vladtarakin178-maker/aiai-car/chassis/body_preview_back.png

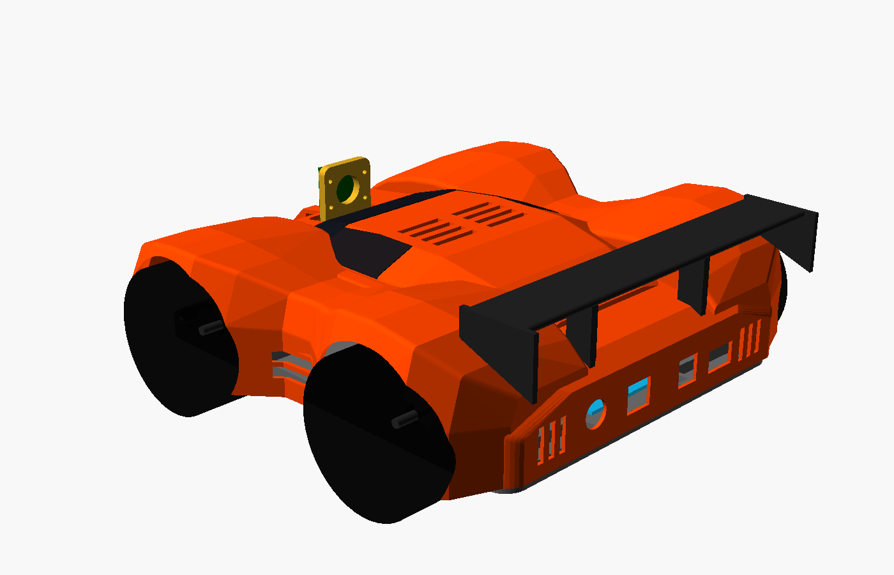
chassis/body_preview_back.png
