vladtarakin178-maker/aiai-car/chassis/body_preview_fit.png

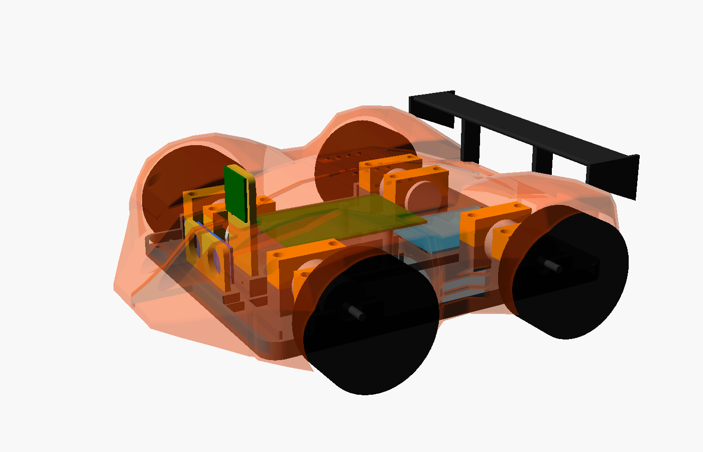
chassis/body_preview_fit.png
