vladtarakin178-maker/aiai-car/chassis/body_side.png

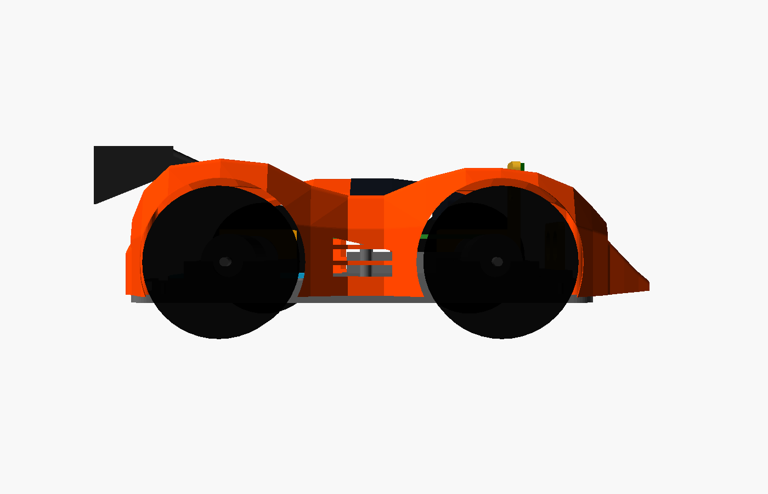
chassis/body_side.png
