vladtarakin178-maker/aiai-car/chassis/stl/body_fr.stl

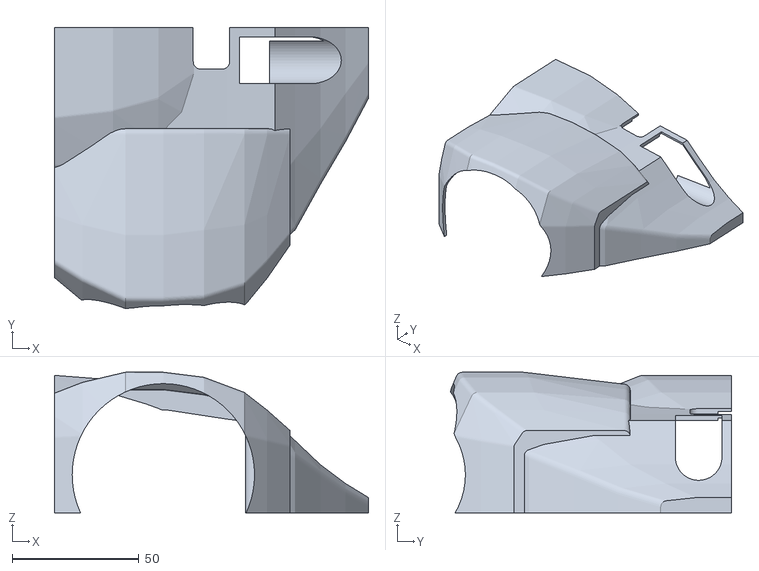
[picture p6: CAD file, 2026-10-30]
chassis/stl/body_fr.stl
124.0 x 111.0 x 55.5
