vladtarakin178-maker/aiai-car/chassis/stl/wing.stl

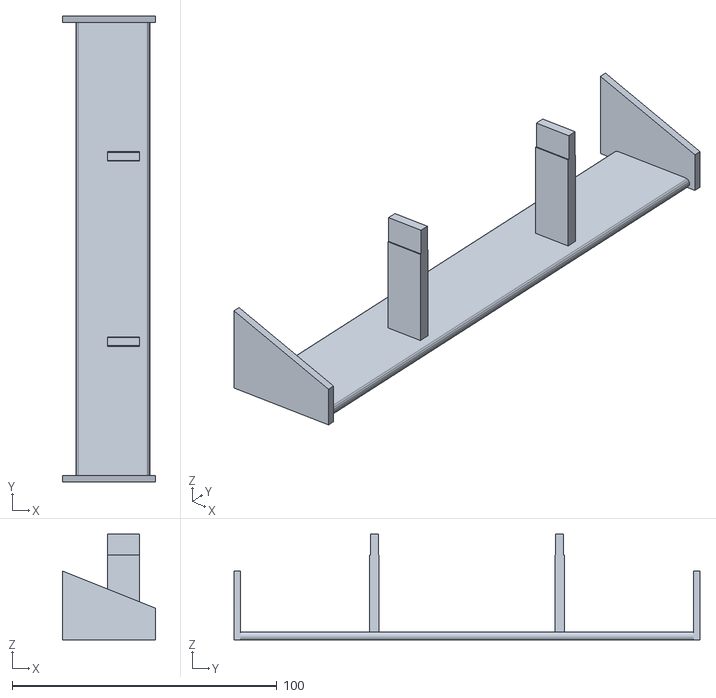
[picture p7: CAD file, 2026-10-30]
chassis/stl/wing.stl
35.0 x 176.0 x 40.0
