vladtarakin178-maker/aiai-car/chassis/stl/body_rl.stl

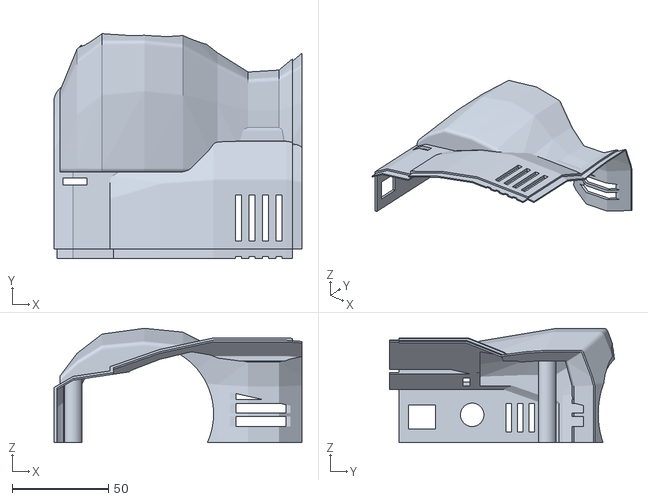
[picture p8: CAD file, 2026-10-30]
chassis/stl/body_rl.stl
129.0 x 117.0 x 59.5
