vladtarakin178-maker/aiai-car/chassis/stl/body_fl.stl

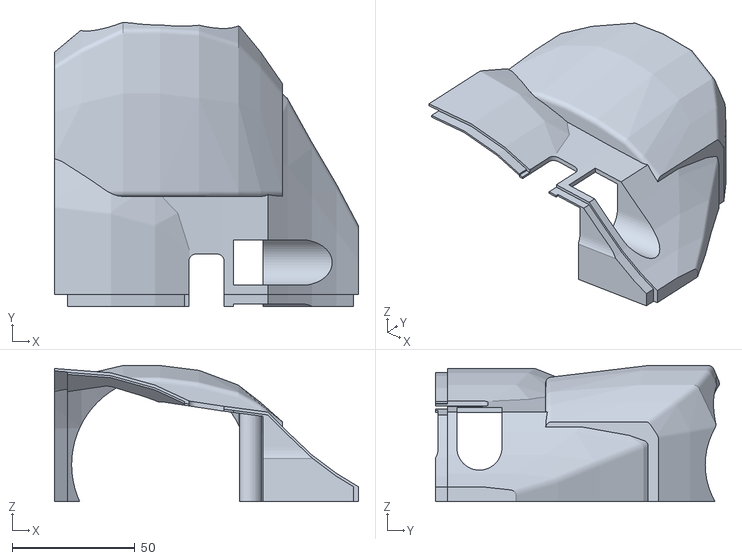
[picture p9: CAD file, 2026-10-30]
chassis/stl/body_fl.stl
124.0 x 116.0 x 55.5
