vladtarakin178-maker/aiai-car/chassis/stl/body_rr.stl

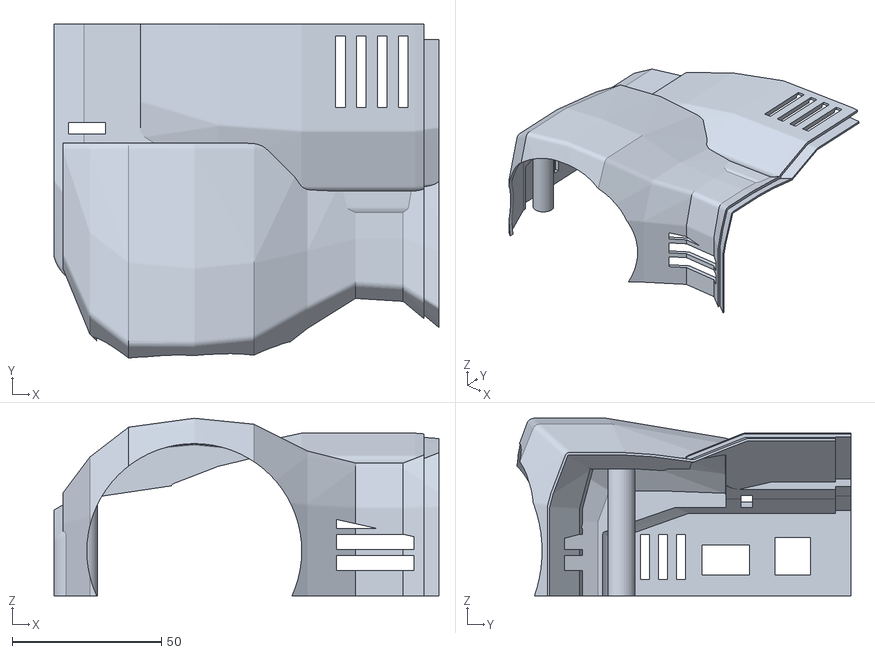
[picture p10: CAD file, 2026-10-30]
chassis/stl/body_rr.stl
129.0 x 112.0 x 59.5
