vladtarakin178-maker/aiai-car/chassis/stl/plate.stl

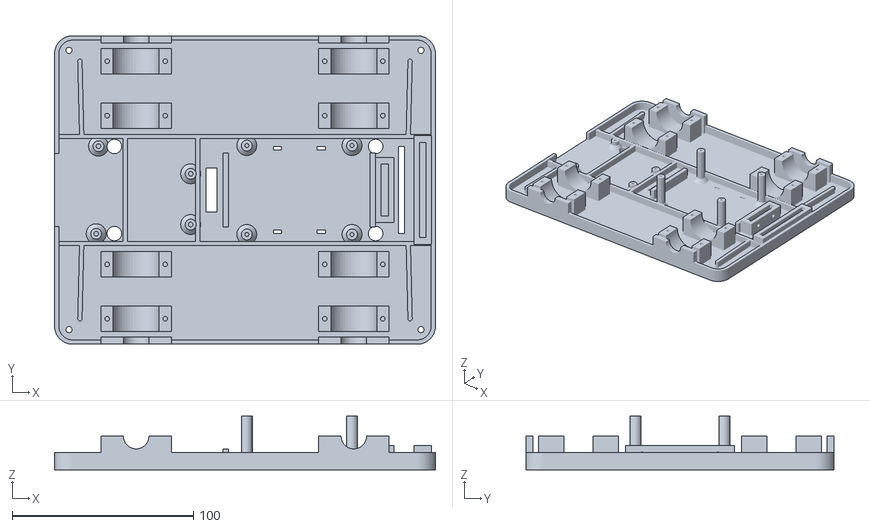
[picture p11: CAD file, 2026-10-30]
chassis/stl/plate.stl
210.0 x 170.0 x 29.5
