vladtarakin178-maker/aiai-car/chassis/stl/mast.stl

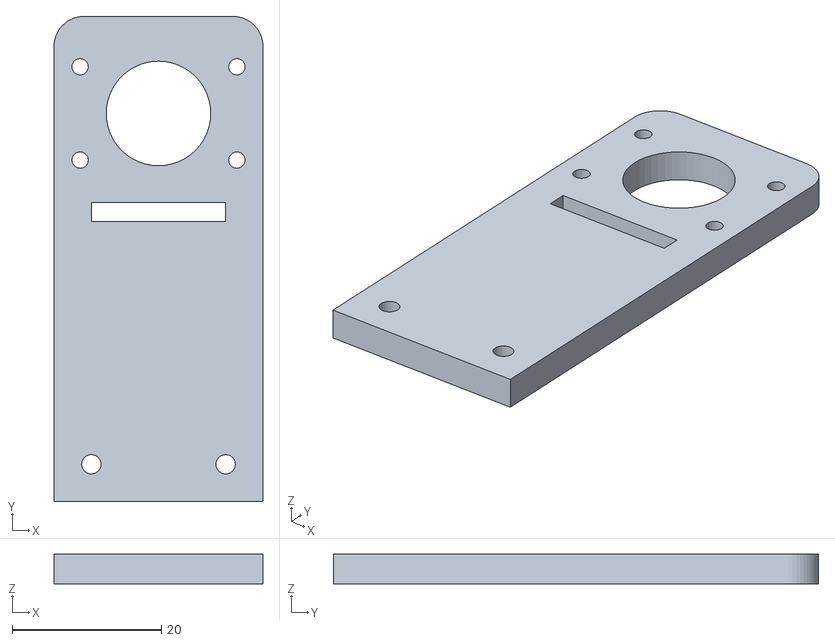
[picture p12: CAD file, 2026-10-30]
chassis/stl/mast.stl
28.0 x 65.0 x 4.00
