vladtarakin178-maker/aiai-car/chassis/stl/clamp.stl

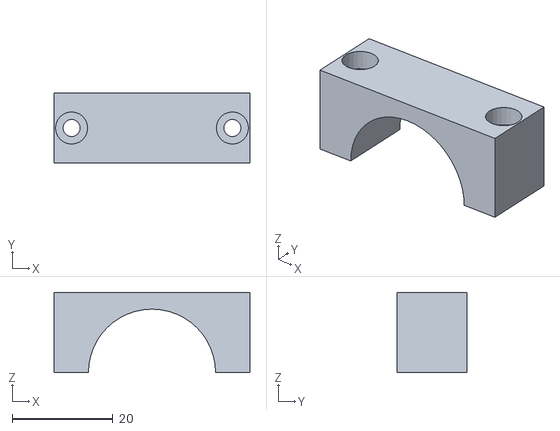
[picture p13: CAD file, 2026-10-30]
chassis/stl/clamp.stl
39.0 x 14.0 x 16.0
