vladtarakin178-maker/aiai-car/chassis/stl/sensor.stl

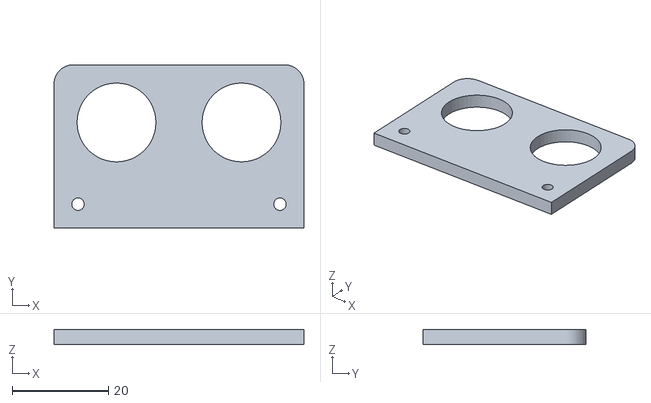
[picture p14: CAD file, 2026-10-30]
chassis/stl/sensor.stl
52.0 x 34.0 x 3.20
