vladtarakin178-maker/aiai-car/chassis/stl/sensor_servo.stl

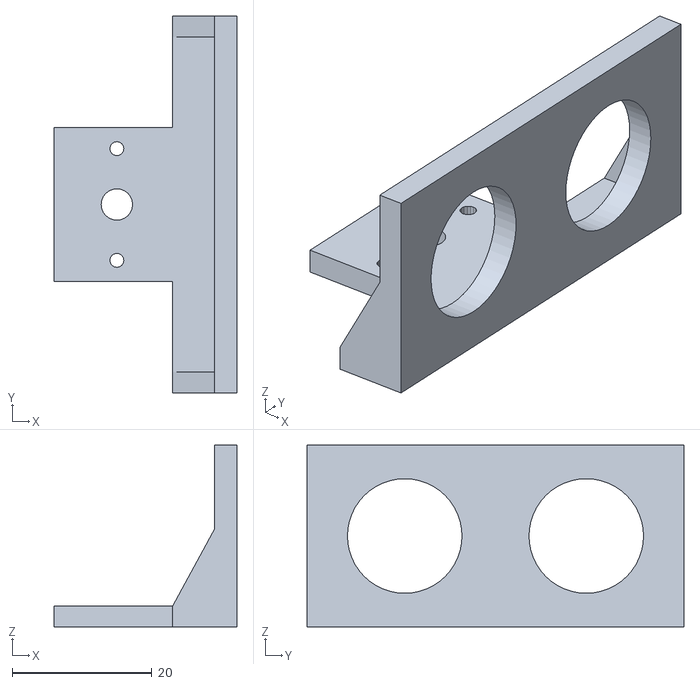
[picture p15: CAD file, 2026-10-30]
chassis/stl/sensor_servo.stl
26.2 x 54.0 x 26.0
