vladtarakin178-maker/aiai-car/(commit log)

2026-10-24 Начало проекта
2026-10-30 Добавлено параметрическое шасси (OpenSCAD), STL и описание
    [aiai_chassis.scad, clamp.stl, mast.stl, plate.stl, sensor.stl, sensor_servo.stl]
2026-10-30 Кузов спорткар: aiai_body.scad, STL, превью, README
    [aiai_body.scad, body_front.stl, body_rear.stl, body_whole.stl, spoiler.stl]
2026-10-30 Кузов-суперкар: клиновидный нос, широкие крылья, 4 четверти + заднее крыло
    [aiai_body.scad, body_fl.stl, body_fr.stl, body_front.stl, body_rear.stl, body_rl.stl, body_rr.stl, body_whole.stl]
